johnjones4/white-vest/stl/bottom_bracket.stl

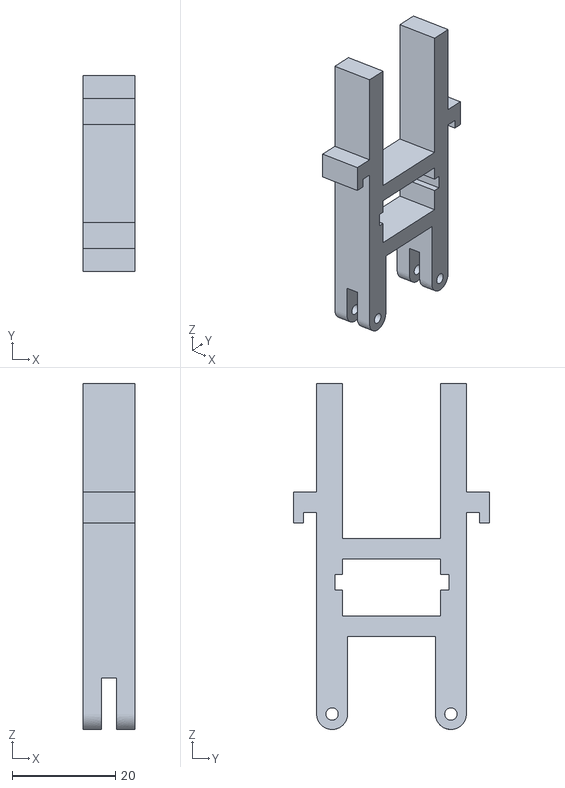
[picture p3: CAD file, 2020-09-29, last stored version]
stl/bottom_bracket.stl
10.0 x 38.0 x 67.0
