johnjones4/white-vest/stl/crossbar.stl

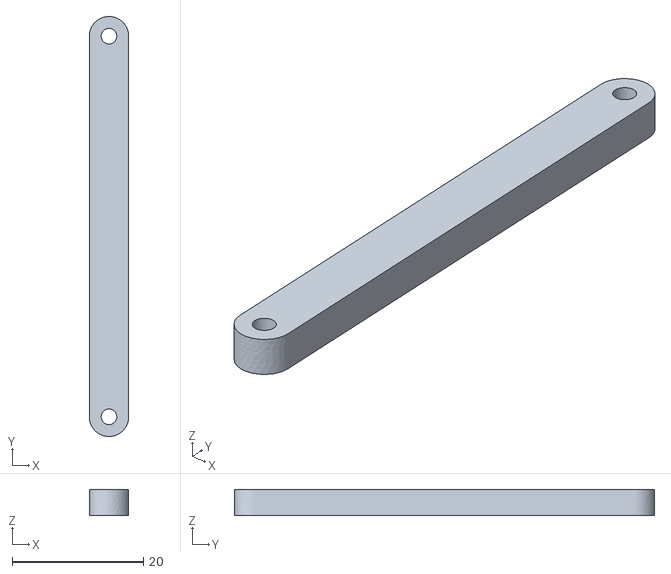
[picture p4: CAD file, 2020-09-29, last stored version]
stl/crossbar.stl
6.00 x 64.0 x 4.00
