johnjones4/white-vest/stl/camera_mount.stl

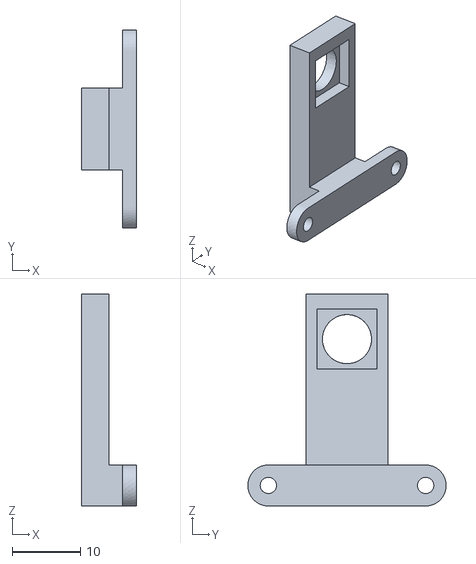
[picture p5: CAD file, 2020-09-29, last stored version]
stl/camera_mount.stl
8.00 x 29.0 x 31.0
