johnjones4/white-vest/stl/top_bracket.stl

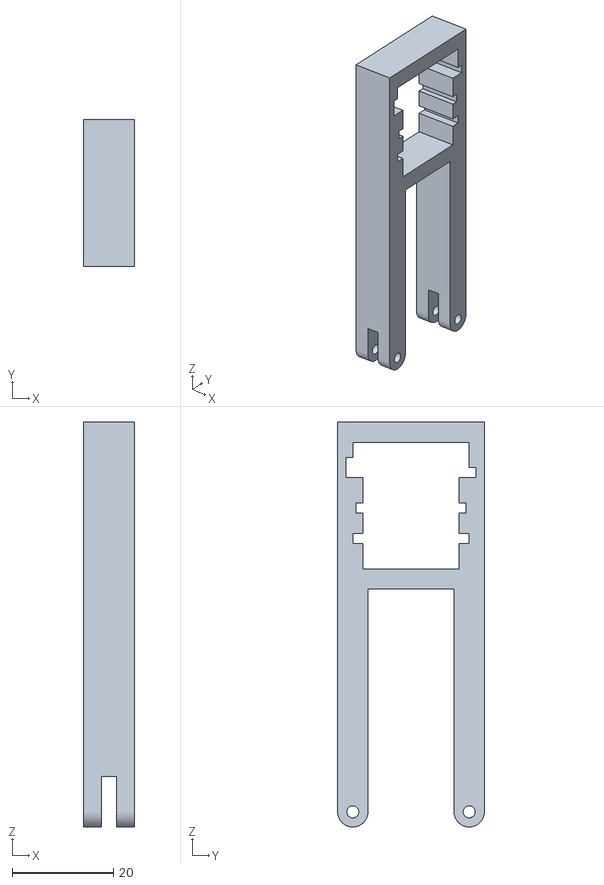
[picture p6: CAD file, 2020-09-29, last stored version]
stl/top_bracket.stl
10.0 x 29.0 x 80.0
