johnjones4/white-vest/stl/separator.stl

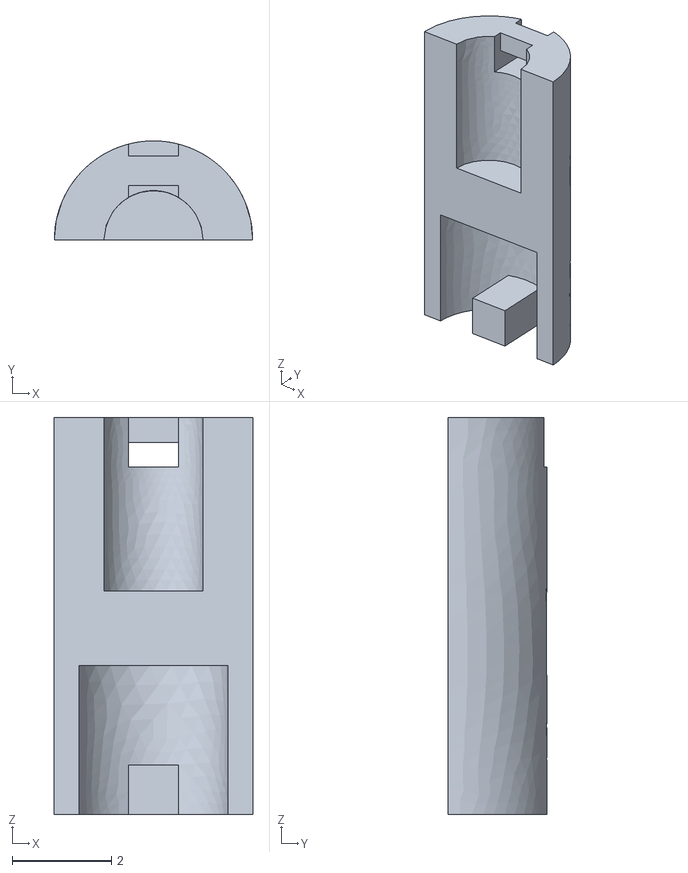
[picture p7: CAD file, 2020-09-29, last stored version]
stl/separator.stl
4.00 x 2.00 x 8.00
