johnjones4/white-vest/(threads)

Thread 1 (2022-03-01):

Berrygps-imu v4

pewpeww39, 2022-03-01:
I'm trying to figure out how to contact you. I have a rpi zero with a berrygps-Imu that I want to use on my rocket. I also want the live feed though. I'm trying to figure out how hard it would be to use your code to work with the berrygps. They have the same pressure sensor, but the altimeter and gyro for the berry are lsm6dsl where yours was a lsm303. There are a few more features on the berry hat, but if I could get those to work it would be in the right direction.

Thread 2 (2022-09-01):

Launch checklist?

k3tch4p, 2022-09-01:
Hi, didn't see a good way to contact you other than opening an issue.

Since you have a pi in the rocket, I thought maybe your telemetry module could either step outside of that boundary or another module could be made for control.

The idea is this:

1. Your control program performs a pre-launch checklist to make sure all the pieces are working prior to launch.
2. This includes each intended to be active for the flight.
3. It may or may not include wireless contact with the ground device.
4. It may or may not include a manually closed switch operated by a human, or a button you push on the ground device. Or just a command you enter saying go.
5. Control module lights the candle from inside the rocket. Or tells the ground device to do so.

The github account is new because all my projects to date have been on a work account. But the email address is real, so if you respond here I will see it.

Thanks.
