johnjones4/white-vest/(commit log)

2020-09-29 added STL files
    [bottom_bracket.stl, camera_mount.stl, crossbar.stl, separator.stl, top_bracket.stl]
2020-11-25 switched to typescript
2020-11-26 ready for testing
    [bottom_bracket.stl, camera_mount.stl, crossbar.stl, separator.stl, top_bracket.stl]
2020-11-27 added wiring diagram
2020-12-02 refactored air to use more threads for speed
2021-03-06 refactored to simplify ground
2021-03-09 added flag for running camera
2021-04-13 porting dashboard to go and ground to arduino
2021-04-13 removed ground test
2021-05-09 added support for reset button
2021-06-04 added switch
